marrdm/SmartThermometer/components.docx

1Components

2015-02-14

Total Cost: 512.6 SEK

ELFA

LCD

Name: Dot matrix LCD display 5.57 mm 2 x 16, EA DOGM162W-A

Notes: Stock Number: 75-407-54, 96.4 SEK

Datasheet: https://www1.elfa.se/data1/wwwroot/assets/datasheets/dogm-textdisplay_eng_tds.pdf

NOTE: LCD and Backlight must be bought separately.

Backlight

Blue: Stock Number: 75-408-13, Should be used with EA DOGM162W-A, 68.3 SEK

https://www.elfa.se/elfa3~se_en/elfa/init.do?item=75-408-13&toc=0&q=EA+LED55x31-B

White: Stock Number: 75-408-22, Should be used with EA DOGM162W-A, 80.5 SEK

https://www.elfa.se/elfa3~se_en/elfa/init.do?item=75-408-22&toc=20358

Temperature Sensor

Name: Temperature sensor DO-34, KTY83/110

Notes: Stock Number: 73-538-79, 1.3 degrees accuracy at 25 degrees C, part number: KTY83/110, 9.02 SEK, through-hole, buy 2

Datasheet: https://www1.elfa.se/data1/wwwroot/assets/datasheets/KTY83_series_eng_tds.pdf

Micro SD card

Name: microSDHC card 4 GB, SDC4/4GB

Notes: Stock Number: 73-818-69, 4GB, Kingston, 37.8 SEK, Availability 1-3 days

Datasheet: https://www1.elfa.se/data1/wwwroot/assets/datasheets/sdc4_eng_datasheet.pdf

Micro SD Card Holder

Name: Memory Card Connector, 49619-1611

Notes: Stock Number: 10-270-01, Molex, 45.5 SEK, Pins on the side, easier to solder

Datasheet: https://www1.elfa.se/data1/wwwroot/assets/datasheets/496191611_sd.pdf

Mini USB Connector

Name: Socket, angled mini-USB B 5P

Notes: Stock Number: 42-571-03, Type B, 11.4 SEK

Datasheet: https://www1.elfa.se/data1/wwwroot/assets/datasheets/4257103_eng_datasheet.pdf

RGB LED

Name: SMD LED RGB 1.75...3.5 V PLCC-4, 67-03/BHGHR6W-B11/2T

Notes: Stock Number: 10-422-52, Common Anode, 9.78 SEK

Datasheet: https://www1.elfa.se/data1/wwwroot/assets/datasheets/67-03-BHGHR6W-B11-2T_eng_tds.pdf

Button

Name: PCB Switch black, B3FS-4002P

Notes: Stock Number: 35-591-99, SMD, 6 SEK

Datasheet: https://www1.elfa.se/data1/wwwroot/assets/datasheets/B3FS-4_eng_tds.pdf

Battery

Name: LiPo-Battery 3.7 V 700 mAh, SLPB393459H TW

Notes: Stock Number: 10-752-32, No picture, 57 SEK

Datasheet: https://www1.elfa.se/data1/wwwroot/assets/datasheets/eo972101_e.pdf

Battery Holder

2 Pin Header

Battery Charging Chip

Name: Battery Charging IC 3.75...6 V SOT-23-5, MCP73831T-2ACI/OT

Notes: Stock Number: 73-869-33, 5.33 SEK, 500 mA output current, LDO

Datasheet: https://www1.elfa.se/data1/wwwroot/assets/datasheets/mcp73831-2_eng_tds.pdf

Voltage Regulator

Name: LDO V-regulator 3.3 V SO-8, MCP1725-3302E/SN

Notes: Stock Number: 73-867-77, 8.07 SEK, 500 mA output current, LDO

Datasheet: https://www1.elfa.se/data1/wwwroot/assets/datasheets/mcp1725_eng_tds.pdf

Transistors

Name: Transistor SOT-23 NPN 30 V, BC848C

Notes: Stock Number: 71-311-81, N-MOS, SOT23 package, 0.564 SEK, Design requires 8

Datasheet: https://www1.elfa.se/data1/wwwroot/assets/datasheets/uiBC646-to-BC848_e.pdf

Crystal for RTC

Name: Quartz SMD 32.768 kHz, KX-327L 12,5 CRYSTAL 32,76

Notes: Stock Number: 74-537-12, 16.2 SEK

Datasheet: https://www1.elfa.se/data1/wwwroot/assets/datasheets/GEYER-KX-327L.pdf

4.7 uF capacitors

Name: Capacitor SMD 4.7 uF 25 VDC 0805, GRM21BR61E475KA12L

Notes: Stock Number: 65-502-71, 4.7uF capacitor, 0805, 1.58 SEK, Design requires 5

Datasheet:https://www1.elfa.se/data1/wwwroot/assets/datasheets/GRM21BR61E475KA12L_eng_tds.pdf

10 uF capacitors

Name: Capacitor SMD 10 uF 25 VDC 0805, GRM21BR61E106KA73L

Notes: Stock Number: 65-768-30, 10uF capacitor, 0805, 1.82 SEK, Design requires 2

Datasheet:https://www1.elfa.se/data1/wwwroot/assets/datasheets/GRMSeries_HighDielectricType_eng.pdf

Jumper

Name: JumperP, C2700-02AATB00R

Notes: Stock Number: 13-711-10, 1.27 SEK

Farnell

RTC

Name: MICROCHIP MCP79510-I/MS RTCC, SPI, 1KB EE, 64B SRAM, MSOP-10 Notes: Orderkod: 2361124, 11.5 SEK, Microchip

Datasheet: http://www.farnell.com/datasheets/1726341.pdf

Crystal

Name: TXC 9C-12.000MAAJ-T XTAL, 12.000MHZ, 18PF, SMD, HC-49S

Notes: Orderkod: 1842280, SMD, 4 SEK

Datasheet: http://www.txccrystal.com/images/pdf/9c.pdf

Demultiplexer

# Name: NXP 74CBTLV3253PW,118 DEMULTIPLEXERARE, DBL, 2 I/P, TSSOP-16

Notes: Orderkod:2445274, 5.75 SEK, 2 channel, 1:4

Datasheet: http://www.farnell.com/datasheets/1649063.pdf

Microcontroller

# Name: NXP LPC11C24FBD48/301, MCU, 32BIT, CORTEX-M0, 50MHZ, LQFP-48

Notes: Orderkod:2072192, 47.05 SEK

Datasheet: http://www.farnell.com/datasheets/1708214.pdf

FTDI 231X

# Name: FTDI FT231XS I/F,USB2.0 FS TO F/L H/S UART,20SSOP

Notes: Orderkod:2081328, 19.5 SEK

Datasheet: http://www.ftdichip.com/Support/Documents/DataSheets/ICs/DS_FT231X.pdf
