marrdm/SmartThermometer/smartThermometer_Rev_1.4/smartThermometer.brd

## EAGLE design smartThermometer_Rev_1.4/smartThermometer.brd (2015-03-03, an earlier design)

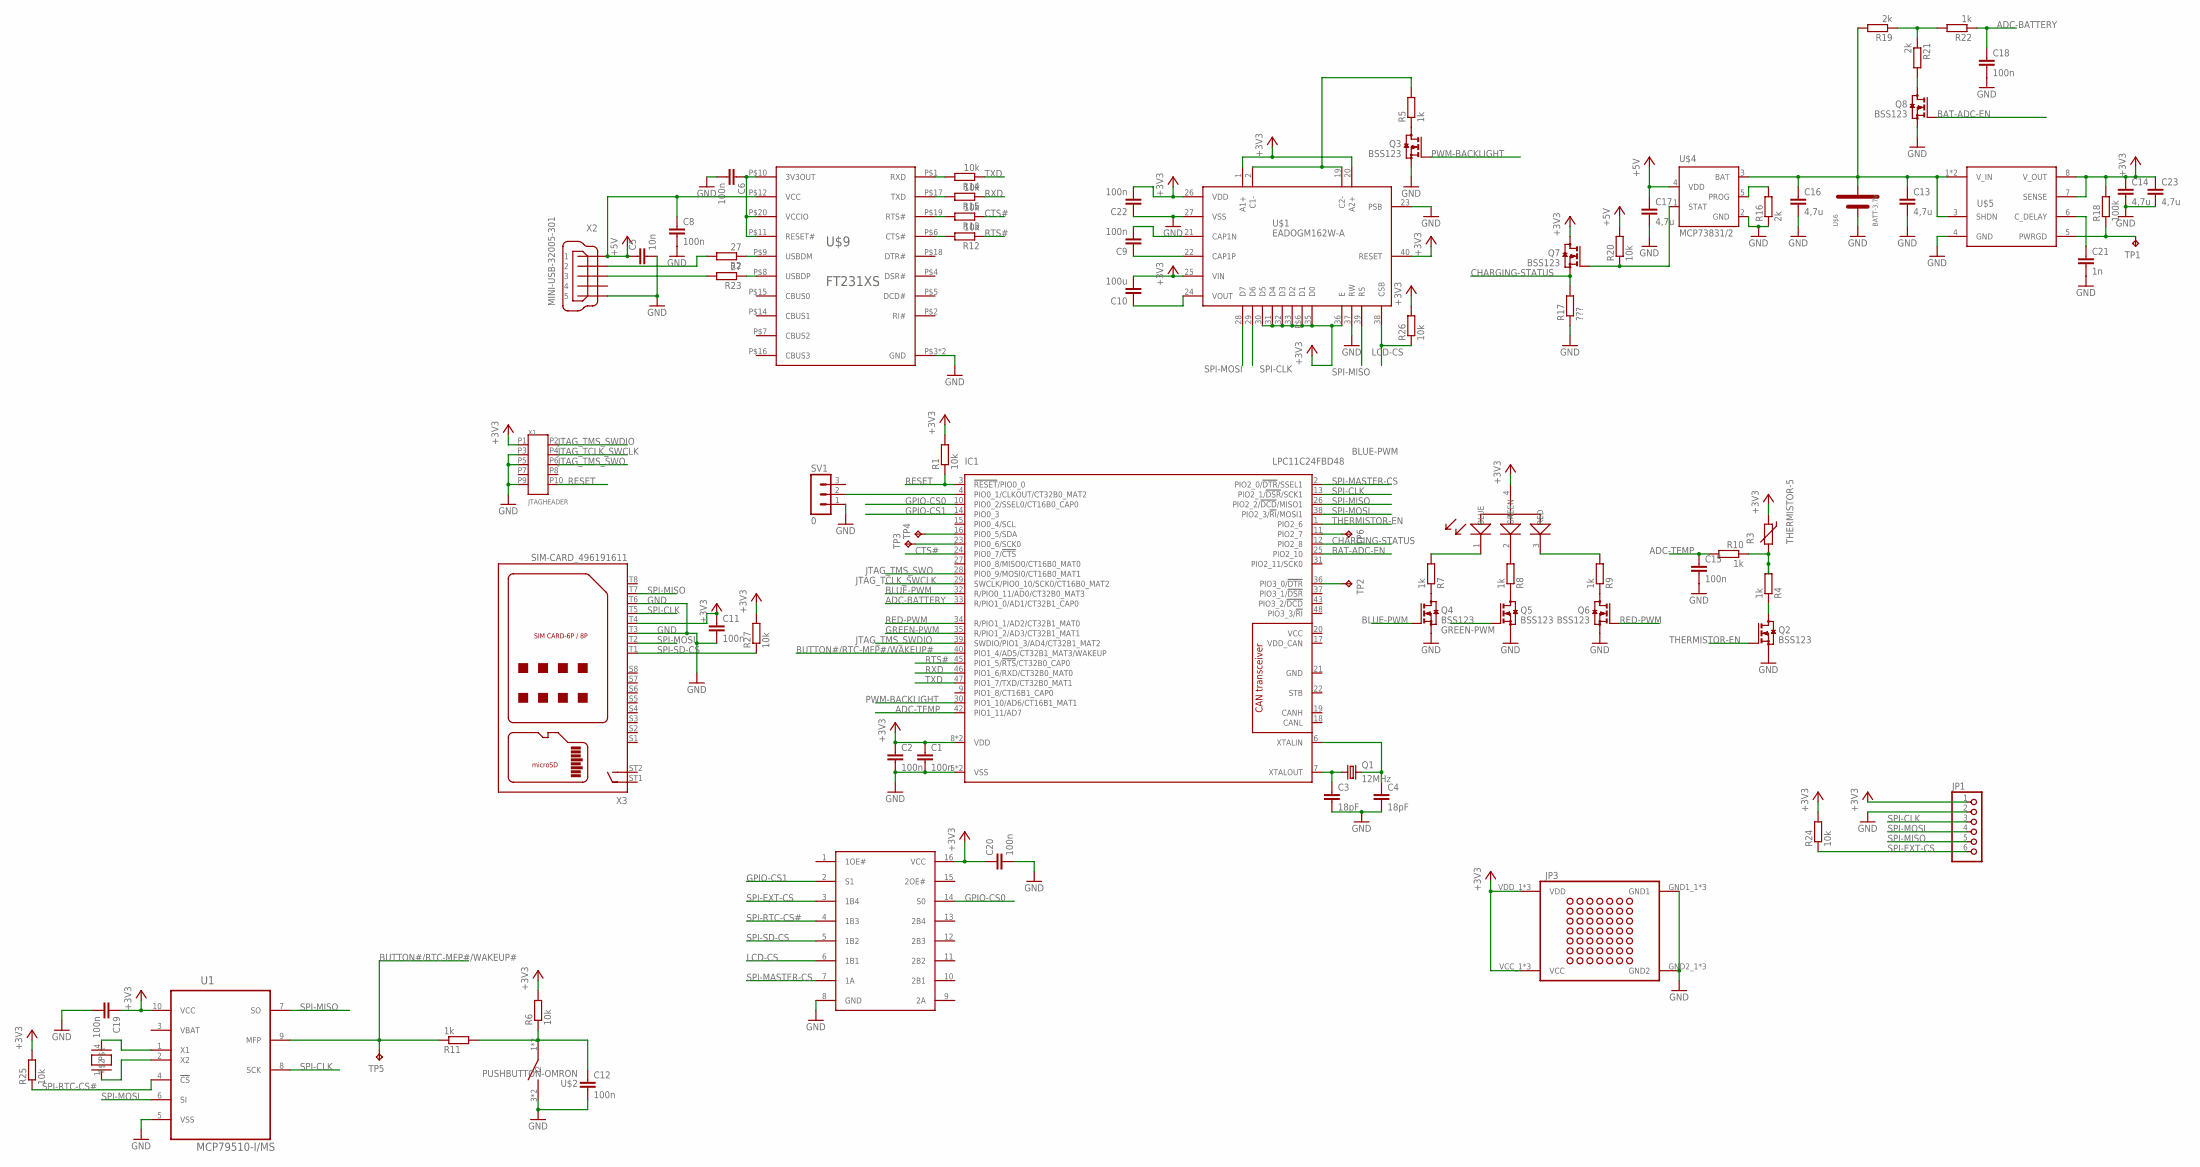
[picture p1: schematic smartThermometer.sch]

Parts:
C1, C2, C6, C8, C9, C11, C12, C15, C18, C19, C20, C22: 100n; C0603
C3, C4: 18pF; C0603
C5: 10n; C0603
C10: 100u; C0603
C13, C14, C16, C17, C23: 4,7u; C0805
C21: 1n; C0603
IC1: LPC11C24FBD48; SOT313-2
JP1: PINHD-1X6; 1X06
JP3: PROTOTYPE_2U_SMALL; PROTOTYPE8X6
Q1: 12MHz; HC49UP
Q2, Q3, Q4, Q5, Q6, Q7, Q8: BSS123; SOT23
R1, R6, R12, R13, R14, R15, R20, R24, R25, R26, R27: 10k; R0603
R2, R23: 27; R0603
R3: THERMISTOR-5; R-5
R4, R5, R7, R8, R9, R10, R11, R22: 1k; R0603
R16, R19, R21: 2k; R0603
R17: ???; R0603
R18: 100k; R0603
SV1: 0; MA03-1
TP1: TPTP18SQ; TP18SQ
TP2, TP3, TP4, TP5, TP6: TPTP16SQ; TP16SQ
U1: MCP79510-I/MS; SOP50P490X110-10N
U$1: EADOGM162W-A; LCD_FOOTPRINT
U$2: PUSHBUTTON-OMRON; PUSHBUTTON-OMRON-B3FS-4002P
U$3: LED-RGB-EVERLIGHT
U$4: MCP73831/2; SOT23-5L
U$5: MCP1725; SO08
U$6: BATT-3.7V; MA02-1+-
U$7: CRYSTAL-32.768KHZ-GEYER; 32.768KHZ
U$8: DEMUX-1-4-NXP; TSSOP16
U$9: FT231XS; SSOP20
X1: JTAGHEADER; HEADER10
X2: MINI-USB-32005-301; 32005-301
X3: SIM-CARD_496191611

Connections:
+3V3: C1.1, C2.1, C10.2, C11.1, C14.1, C19.1, C20.1, C22.2, C23.1, IC1.8 (VDD), IC1.44 (VDD), JP1.1, JP3.VCC_1 (VCC), JP3.VCC_2 (VCC), JP3.VCC_3 (VCC), JP3.VDD_1 (VDD), JP3.VDD_2 (VDD), JP3.VDD_3 (VDD), Q7.3 (D), R1.2, R3.1, R6.2, R18.2, R24.2, R25.2, R26.2, R27.2, U1.10 (VCC), U$1.1 (A1+), U$1.20 (A2+), U$1.25 (VIN), U$1.26 (VDD), U$1.30 (D5), U$1.31 (D4), U$1.32 (D3), U$1.33 (D2), U$1.35 (D0), U$1.36 (E), U$1.40 (RESET), U$1.P$6 (D1), U$3.4, U$5.7 (SENSE), U$5.8 (V_OUT), U$8.16 (VCC), X1.P1, X3.T4
+5V: C5.1, C8.1, C17.1, R20.2, U$4.4 (VDD), U$9.P$12 (VCC), X2.1
ADC: R3.2, R4.2, R10.1
ADC-BATTERY: C18.1, IC1.33 (R/PIO1_0/AD1/CT32B1_CAP0), R22.1
ADC-TEMP: C15.1, IC1.42 (PIO1_11/AD7), R10.2
BAT-ADC-EN: IC1.25 (PIO2_10), Q8.1 (G)
BLUE-PWM: IC1.32 (R/PIO0_11/AD0/CT32B0_MAT3), Q4.1 (G)
BUTTON#/RTC-MFP#/WAKEUP#: IC1.40 (PIO1_4/AD5/CT32B1_MAT3/WAKEUP), R11.1, TP5.TP, U1.9 (MFP)
CHARGING-STATUS: IC1.12 (PIO2_8), Q7.2 (S), R17.2
CTS#: IC1.24 (PIO0_7/!CTS!), R13.1
GND: C1.2, C2.2, C3.2, C4.2, C5.2, C6.2, C8.2, C11.2, C12.2, C13.2, C14.2, C15.2, C16.2, C17.2, C18.2, C19.2, C20.2, C21.2, C22.1, C23.2, IC1.5 (VSS), IC1.21 (GND), IC1.41 (VSS), JP1.2, JP3.GND1_1 (GND1), JP3.GND1_2 (GND1), JP3.GND1_3 (GND1), JP3.GND2_1 (GND2), JP3.GND2_2 (GND2), JP3.GND2_3 (GND2), Q2.2 (S), Q3.2 (S), Q4.2 (S), Q5.2 (S), Q6.2 (S), Q8.2 (S), R16.1, R17.1, SV1.1, U1.5 (VSS), U$1.23 (PSB), U$1.27 (VSS), U$1.37 (RW), U$2.3 (2), U$2.4 (2), U$4.2 (GND), U$5.4 (GND), U$6.2 (BAT-), U$8.8 (GND), U$9.P$3 (GND), U$9.P$13 (GND), X1.P3, X1.P5, X1.P9, X2.5, X3.T3, X3.T6
GPIO-CS0: IC1.10 (PIO0_2/SSEL0/CT16B0_CAP0), U$8.14 (S0)
GPIO-CS1: IC1.14 (PIO0_3), U$8.2 (S1)
GREEN-PWM: IC1.35 (R/PIO1_2/AD3/CT32B1_MAT1), Q5.1 (G)
JTAG_TCLK_SWCLK: IC1.29 (SWCLK/PIO0_10/SCK0/CT16B0_MAT2), X1.P4
JTAG_TMS_SWDIO: IC1.39 (SWDIO/PIO1_3/AD4/CT32B1_MAT2), X1.P2
JTAG_TMS_SWO: IC1.28 (PIO0_9/MOSI0/CT16B0_MAT1), X1.P6
LCD-CS: R26.1, U$1.38 (CSB), U$8.6 (1B1)
unnamed: R2.2, X2.2
unnamed: R23.2, X2.3
unnamed: C3.1, IC1.7 (XTALOUT), Q1.1
unnamed: C4.1, IC1.6 (XTALIN), Q1.2
unnamed: C9.2, U$1.21 (CAP1N)
unnamed: C6.1, U$9.P$10 (3V3OUT), U$9.P$11 (RESET#), U$9.P$20 (VCCIO)
unnamed: C9.1, U$1.22 (CAP1P)
unnamed: C10.1, U$1.24 (VOUT)
unnamed: Q2.3 (D), R4.1
unnamed: R5.2, U$1.2 (C1-), U$1.19 (C2-)
unnamed: Q3.3 (D), R5.1
unnamed: R2.1, U$9.P$9 (USBDM)
unnamed: R8.2, U$3.2 (GREEN)
unnamed: R7.2, U$3.1 (BLUE)
unnamed: R9.2, U$3.3 (RED)
unnamed: Q4.3 (D), R7.1
unnamed: Q5.3 (D), R8.1
unnamed: Q6.3 (D), R9.1
unnamed: IC1.4 (PIO0_1/CLKOUT/CT32B0_MAT2), SV1.2
unnamed: C13.1, C16.1, R19.2, U$4.3 (BAT), U$5.1 (V_IN), U$5.2 (V_IN), U$5.3 (SHDN), U$6.1 (BAT+)
unnamed: R16.2, U$4.5 (PROG)
unnamed: R19.1, R21.1, R22.2
unnamed: Q7.1 (G), R20.1, U$4.1 (STAT)
unnamed: R14.2, U$9.P$1 (RXD)
unnamed: R15.2, U$9.P$17 (TXD)
unnamed: C21.1, U$5.6 (C_DELAY)
unnamed: R18.1, TP1.TP, U$5.5 (PWRGD)
unnamed: R13.2, U$9.P$19 (RTS#)
unnamed: R12.2, U$9.P$6 (CTS#)
unnamed: U1.1 (X1), U$7.4
unnamed: U1.2 (X2), U$7.1
unnamed: Q8.3 (D), R21.2
unnamed: R23.1, U$9.P$8 (USBDP)
unnamed: IC1.36 (PIO3_0/!DTR!), TP2.TP
unnamed: IC1.23 (PIO0_6/SCK0), TP3.TP
unnamed: IC1.16 (PIO0_5/SDA), TP4.TP
unnamed: IC1.11 (PIO2_7), TP6.TP
unnamed: C12.1, R6.1, R11.2, U$2.1, U$2.2 (1)
PWM-BACKLIGHT: IC1.30 (PIO1_10/AD6/CT16B1_MAT1), Q3.1 (G)
RED-PWM: IC1.34 (R/PIO1_1/AD2/CT32B1_MAT0), Q6.1 (G)
RESET: IC1.3 (!RESET!/PIO0_0), R1.1, X1.P10
RTS#: IC1.45 (PIO1_5/!RTS!/CT32B0_CAP0), R12.1
RXD: IC1.46 (PIO1_6/RXD/CT32B0_MAT0), R15.1
SPI-CLK: IC1.13 (PIO2_1/!DSR!/SCK1), JP1.3, U1.8 (SCK), U$1.29 (D6), X3.T5
SPI-EXT-CS: JP1.6, R24.1, U$8.3 (1B4)
SPI-MASTER-CS: IC1.2 (PIO2_0/!DTR!/SSEL1), U$8.7 (1A)
SPI-MISO: IC1.26 (PIO2_2/!DCD!/MISO1), JP1.5, U1.7 (SO), U$1.39 (RS), X3.T7
SPI-MOSI: IC1.38 (PIO2_3/!RI!/MOSI1), JP1.4, U1.6 (SI), U$1.28 (D7), X3.T2
SPI-RTC-CS#: R25.1, U1.4 (!CS), U$8.4 (1B3)
SPI-SD-CS: R27.1, U$8.5 (1B2), X3.T1
THERMISTOR-EN: IC1.1 (PIO2_6), Q2.1 (G)
TXD: IC1.47 (PIO1_7/TXD/CT32B0_MAT1), R14.1

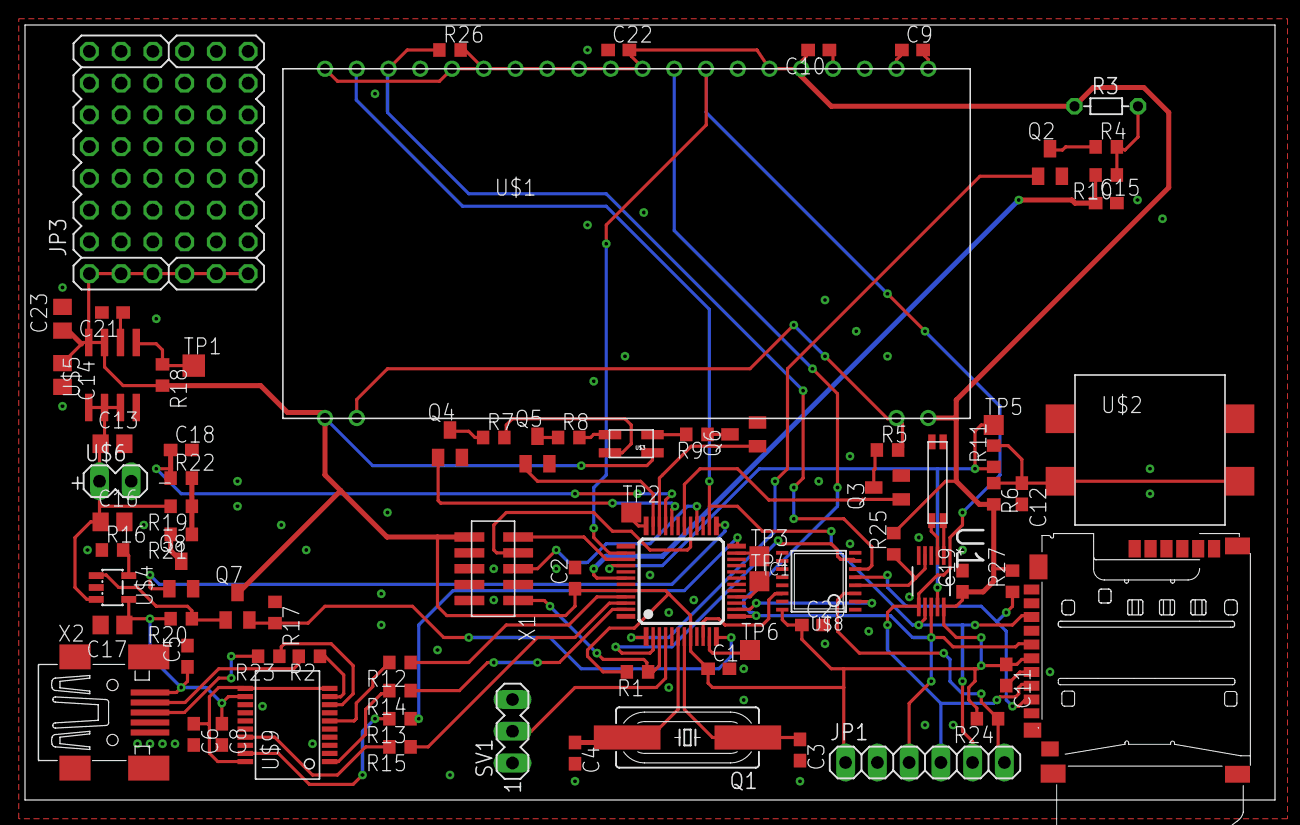
[picture p2: board smartThermometer.brd from above]

Board: 2 copper layers, 100.0 x 62.0 mm, 80 parts (0 on the bottom side), 70 nets.
