marrdm/SmartThermometer/(commit log)

2015-03-03 Added Eagle schematics
    [smartThermometer.brd, smartThermometer.sch]
2015-03-03 tweak schematic
    [smartThermometer.sch]
2015-03-04 Added SmartThermometer_Rev_2. Fixed broken footplrints
    [smartThermometer.brd, smartThermometer.sch]
2015-03-06 Added Software, pwm test
2015-03-09 Improved pwm
2015-03-13 pwm update
2015-03-13 Added interrupt code for timer, UART, button and AD
2015-03-13 Added timer 32B0 setup code
2015-03-13 added basic UART buffer
    buffer is currently non-functional
2015-03-16 Fixed timer driven ADC
2015-03-18 Changed code to 16 bit timer and started SPI code
2015-03-19 UART working
2015-03-19 SPI and LCD code
2015-03-23 Added SPI test code
2015-03-23 Moved adc code, added temp.c, fixed bug in str.c
    [SPI.c, SPI.h, Software.c, Software.h, adc.c, adc.h, pwm.c, str.c]
2015-03-24 SPI testing
2015-03-24 allow pwm duty cycle to be 0
